AustinZhai8/Smart-Alarm/SmartAlarm/SmartAlarm.ino

#include <TFT_eSPI.h>
#include <WiFi.h>
#include <time.h>
#include <Wire.h>
#include <MPU6050.h>
#include <SPI.h>
#include <SD.h>
#include <HTTPClient.h>
#include <ArduinoJson.h>
#include <EEPROM.h>
#include <ezButton.h>
#include "secrets.h"
#include "sleep_classifier.h"
#include "smart_alarm_features.h"

// pins
#define BL_PIN     32
#define BTN_PIN    33    // sleep / back
#define SD_CS       5
#define BUZZER_PIN 25
#define CLK_PIN    16    // encoder CLK (interrupt)
#define DT_PIN      4    // encoder DT
#define SW_PIN     34    // encoder button

// home screen colors
#define C_OFFWHITE  0xDEDB
#define C_DIM       0x7BEF
#define C_DIMMER    0x4208
uint16_t C_CYAN;

// menu colors
#define COL_BG        0x0000
#define COL_TEXT      0xF77C  // off-white
#define COL_ACCENT    0x8E9F  // cyan
#define COL_DEEP      0x9C5E  // purple
#define COL_KNOBTEXT  0x08A3  // text on accent fills
#define COL_TEXT_75   0xB596
#define COL_TEXT_55   0x8410
#define COL_TEXT_40   0x630C
#define COL_TEXT_30   0x4A49
#define COL_HAIRLINE  0x18E3  // divider
#define COL_DIMSLOT   0x10A2  // slot background

const char* OWM_CITY = "Calgary,CA";

TFT_eSPI tft = TFT_eSPI();
MPU6050  mpu;
ezButton encBtn(SW_PIN);
ezButton backBtn(BTN_PIN);

// navigation
enum Screen {
  HOME, MENU, ALARM_MENU, EDIT_ALARM, EDIT_WAKE,
  SLEEP_DATA, WEATHER, SETTINGS, RESTART, BOOT
};
Screen screen = HOME;
bool   dirty  = true;   // redraw requested

struct AlarmCfg { bool on; uint8_t hour, minute; };       // 24h
struct WakeCfg  { bool on; uint8_t windowMin, sens; };     // 5..60 / 1..3
AlarmCfg alarmCfg = { true, 6, 30 };
WakeCfg  wake  = { true, 30, 2 };
uint8_t  snoozeDurationMin = 10;   // snooze length 1..30

const char* MENU_ITEMS[6] = {
  "Enter Sleep Mode", "Alarm", "Sleep Data", "Weather", "Settings", "Restart"
};
const char* ALARM_ITEMS[2] = { "Edit Alarm", "Smart Alarm" };

uint8_t menuSel    = 1;   // start on "Alarm"
uint8_t alarmSel   = 0;
uint8_t alarmField = 0;   // 0=enabled 1=h 2=m
uint8_t wakeField  = 1;   // 0=enabled 1=minutes 2=sens
bool    rChoiceYes = false;

// alarm ring state
bool          ringing       = false;
unsigned long lastBeepMs    = 0;
bool          alarmFlashOn  = false;
int           lastCheckMin  = -1;
bool          alarmFromSleep = false;   // alarm fired from sleep
unsigned long ringStartMs   = 0;
#define RING_TIMEOUT_MS (3UL * 60UL * 1000UL)   // auto-off after 3 min

// encoder ISR
volatile int  counter   = 0;
volatile unsigned long lastTime = 0;

void IRAM_ATTR ISR_encoder() {
  if ((millis() - lastTime) < 50) return;
  lastTime = millis();
  if (digitalRead(DT_PIN) == HIGH) counter++;
  else                             counter--;
}

// state
bool     sleeping     = false;
String   weatherStr   = "CLEAR · --°";
bool     weatherDirty = true;
char     prevTimeBuf[6]  = "";
char     prevDateBuf[12] = "";
File     dataFile;
int      writeCount   = 0;

// sleep-stage classifier
SmartAlarm::SleepClassifier sleepClf;
File     stageFile;                 // /sleep_stages.csv (timestamp,raw,smoothed)
bool     sleepSummaryDirty = true;  // reparse stage file on next view
bool     smartWakeUsed     = false; // smart wake fires once per session
bool     sleepSessionStarted = false; // no night tracked yet this power-on
unsigned long wakeGuardMs  = 0;     // blocks re-entering sleep after waking
#define  WAKE_GUARD_MS 3000
// last session summary
#define  SEG_MAX 64
uint8_t  segState[SEG_MAX];          // 0 deep, 1 light
uint16_t segCount[SEG_MAX];
int      segN        = 0;
long     sumDeepWin  = 0;            // deep windows
long     sumLightWin = 0;            // light windows
char     sumStart[6] = "";          // first HH:MM
char     sumEnd[6]   = "";          // last HH:MM

// current weather
int   wxTemp = 0, wxHi = 0, wxLo = 0, wxFeels = 0, wxHumidity = 0, wxWind = 0;
char  wxCond[16] = "Clear";

// 5-day forecast
struct DayWx { char wd[4]; uint8_t icon; int hi, lo; };  // icon: 0 sun 1 partly 2 cloud 3 rain
DayWx forecast[5];
bool  forecastReady = false;

unsigned long lastSensorMs  = 0;
unsigned long lastWeatherMs = 0;
const unsigned long WEATHER_MS = 15UL * 60UL * 1000UL;

// EEPROM
#define EE_MAGIC_ADDR  0
#define EE_MAGIC_VAL   0xAB
#define EE_ALARM_ADDR  1   // on, hour, minute
#define EE_WAKE_ADDR   4   // on, windowMin, sens
#define EE_SNOOZE_ADDR 7   // snooze

void saveConfig() {
  EEPROM.write(EE_MAGIC_ADDR, EE_MAGIC_VAL);
  EEPROM.write(EE_ALARM_ADDR + 0, alarmCfg.on);
  EEPROM.write(EE_ALARM_ADDR + 1, alarmCfg.hour);
  EEPROM.write(EE_ALARM_ADDR + 2, alarmCfg.minute);
  EEPROM.write(EE_WAKE_ADDR + 0, wake.on);
  EEPROM.write(EE_WAKE_ADDR + 1, wake.windowMin);
  EEPROM.write(EE_WAKE_ADDR + 2, wake.sens);
  EEPROM.write(EE_SNOOZE_ADDR, snoozeDurationMin);
  EEPROM.commit();
}

void loadConfig() {
  EEPROM.begin(32);
  if (EEPROM.read(EE_MAGIC_ADDR) != EE_MAGIC_VAL) {
    saveConfig();   // first boot: write defaults
    return;
  }
  alarmCfg.on     = EEPROM.read(EE_ALARM_ADDR + 0);
  alarmCfg.hour   = EEPROM.read(EE_ALARM_ADDR + 1);
  alarmCfg.minute = EEPROM.read(EE_ALARM_ADDR + 2);
  wake.on        = EEPROM.read(EE_WAKE_ADDR + 0);
  wake.windowMin = constrain((int)EEPROM.read(EE_WAKE_ADDR + 1), 5, 60);
  wake.sens      = constrain((int)EEPROM.read(EE_WAKE_ADDR + 2), 1, 3);
  snoozeDurationMin = constrain((int)EEPROM.read(EE_SNOOZE_ADDR), 1, 30);
}

// weather
void fetchWeather() {
  if (WiFi.status() != WL_CONNECTED) return;
  HTTPClient http;
  http.setTimeout(5000);
  String url = "http://api.openweathermap.org/data/2.5/weather?q="
               + String(OWM_CITY) + "&appid=" + String(OWM_API_KEY) + "&units=metric";
  http.begin(url);
  int code = http.GET();
  if (code == 200) {
    String payload = http.getString();
    DynamicJsonDocument doc(1024);
    if (!deserializeJson(doc, payload)) {
      int    temp = (int)round(doc["main"]["temp"].as<float>());
      String desc = doc["weather"][0]["main"].as<String>();
      wxTemp     = temp;
      wxHi       = (int)round(doc["main"]["temp_max"].as<float>());
      wxLo       = (int)round(doc["main"]["temp_min"].as<float>());
      wxFeels    = (int)round(doc["main"]["feels_like"].as<float>());
      wxHumidity = doc["main"]["humidity"].as<int>();
      wxWind     = (int)round(doc["wind"]["speed"].as<float>() * 3.6);  // m/s -> km/h
      strncpy(wxCond, desc.c_str(), sizeof(wxCond) - 1);
      wxCond[sizeof(wxCond) - 1] = '\0';
      desc.toUpperCase();
      weatherStr   = desc + " · " + String(temp) + "°";
      weatherDirty = true;
    }
  }
  http.end();
}

// weather condition -> icon index
uint8_t condToIcon(const char* main) {
  if (strstr(main, "Rain") || strstr(main, "Drizzle") || strstr(main, "Thunder")) return 3;
  if (strstr(main, "Cloud")) {
    if (strstr(main, "few") || strstr(main, "scattered")) return 1;
    return 2;
  }
  if (strstr(main, "Clear")) return 0;
  return 1;  // mist/haze/snow -> partly
}

// fetch 5-day forecast (3-hourly, aggregated to daily hi/lo + noon condition)
void fetchForecast() {
  if (WiFi.status() != WL_CONNECTED) return;
  HTTPClient http;
  http.setTimeout(6000);
  String url = "http://api.openweathermap.org/data/2.5/forecast?q="
               + String(OWM_CITY) + "&appid=" + String(OWM_API_KEY) + "&units=metric";
  http.begin(url);
  int code = http.GET();
  if (code != 200) { http.end(); return; }

  // only parse the fields we need
  StaticJsonDocument<200> filter;
  filter["list"][0]["dt"] = true;
  filter["list"][0]["main"]["temp_max"] = true;
  filter["list"][0]["main"]["temp_min"] = true;
  filter["list"][0]["weather"][0]["main"] = true;

  DynamicJsonDocument doc(8192);
  DeserializationError err = deserializeJson(doc, http.getStream(),
                                             DeserializationOption::Filter(filter));
  http.end();
  if (err) return;

  JsonArray list = doc["list"].as<JsonArray>();

  // group by day, up to 5 days
  long    dayKey[5];
  int     dHi[5], dLo[5];
  long    dNoonDelta[5];   // distance from noon of the chosen icon entry
  uint8_t dIcon[5];
  int     nDays = 0;

  for (JsonObject item : list) {
    long dt = item["dt"].as<long>();
    time_t t = (time_t)dt;
    struct tm lt;
    localtime_r(&t, &lt);

    long key = (long)(lt.tm_year) * 1000 + lt.tm_yday;
    long secOfDay = (long)lt.tm_hour * 3600 + lt.tm_min * 60 + lt.tm_sec;
    long noonDelta = labs(secOfDay - 43200L);

    int hi = (int)round(item["main"]["temp_max"].as<float>());
    int lo = (int)round(item["main"]["temp_min"].as<float>());
    const char* mn = item["weather"][0]["main"] | "Clear";

    int idx = -1;
    for (int i = 0; i < nDays; i++) if (dayKey[i] == key) { idx = i; break; }
    if (idx < 0) {
      if (nDays >= 5) continue;
      idx = nDays++;
      dayKey[idx] = key;
      dHi[idx] = hi; dLo[idx] = lo;
      dNoonDelta[idx] = noonDelta; dIcon[idx] = condToIcon(mn);
      strftime(forecast[idx].wd, sizeof(forecast[idx].wd), "%a", &lt);
      for (int c = 0; forecast[idx].wd[c]; c++) forecast[idx].wd[c] = toupper(forecast[idx].wd[c]);
    } else {
      if (hi > dHi[idx]) dHi[idx] = hi;
      if (lo < dLo[idx]) dLo[idx] = lo;
      if (noonDelta < dNoonDelta[idx]) { dNoonDelta[idx] = noonDelta; dIcon[idx] = condToIcon(mn); }
    }
  }

  for (int i = 0; i < nDays; i++) {
    forecast[i].hi = dHi[i];
    forecast[i].lo = dLo[i];
    forecast[i].icon = dIcon[i];
  }
  for (int i = nDays; i < 5; i++) { strcpy(forecast[i].wd, "--"); forecast[i].hi = forecast[i].lo = 0; forecast[i].icon = 1; }
  forecastReady = (nDays > 0);
}

// home screen (incremental redraw to avoid flicker)
void drawStaticElements() {
  tft.drawFastHLine(14, 282, 212, 0x2104);
}

void redrawBottomBar() {
  tft.fillRect(0, 287, 240, 33, TFT_BLACK);
  tft.setTextColor(C_DIMMER, TFT_BLACK);
  tft.drawString(weatherStr, 14, 302, 2);
  char almStr[20];
  if (alarmCfg.on) {
    int h = alarmCfg.hour % 12; if (h == 0) h = 12;
    sprintf(almStr, "ALARM: %d:%02d %s", h, alarmCfg.minute, alarmCfg.hour >= 12 ? "PM" : "AM");
  } else {
    strcpy(almStr, "ALARM: OFF");
  }
  tft.drawString(almStr, 226 - tft.textWidth(almStr, 2), 302, 2);
  weatherDirty = false;
}

void updateDisplay() {
  struct tm ti;
  if (!getLocalTime(&ti)) return;

  char dateBuf[12];
  strftime(dateBuf, sizeof(dateBuf), "%d %b", &ti);
  for (int i = 0; dateBuf[i]; i++) dateBuf[i] = toupper(dateBuf[i]);

  if (strcmp(dateBuf, prevDateBuf) != 0) {
    strcpy(prevDateBuf, dateBuf);
    char dayBuf[12];
    strftime(dayBuf, sizeof(dayBuf), "%A", &ti);
    for (int i = 0; dayBuf[i]; i++) dayBuf[i] = toupper(dayBuf[i]);
    tft.fillRect(0, 18, 200, 32, TFT_BLACK);
    tft.setTextColor(C_DIM, TFT_BLACK);
    tft.drawString(dayBuf, 16, 20, 2);
    tft.setTextColor(C_CYAN, TFT_BLACK);
    tft.drawString(dateBuf, 16, 34, 2);
  }

  int h = ti.tm_hour % 12;
  if (h == 0) h = 12;
  bool isPM = ti.tm_hour >= 12;
  char timeBuf[6];
  sprintf(timeBuf, "%d:%02d", h, ti.tm_min);

  if (strcmp(timeBuf, prevTimeBuf) != 0) {
    strcpy(prevTimeBuf, timeBuf);
    tft.fillRect(0, 95, 240, 80, TFT_BLACK);
    tft.setTextColor(C_OFFWHITE, TFT_BLACK);
    tft.drawString(timeBuf, (240 - tft.textWidth(timeBuf, 7)) / 2, 100, 7);
    tft.fillRect(0, 156, 240, 16, TFT_BLACK);
    tft.setTextColor(C_DIMMER, TFT_BLACK);
    const char* ampm = isPM ? "PM" : "AM";
    tft.drawString(ampm, (240 - tft.textWidth(ampm, 2)) / 2, 158, 2);
  }

  if (weatherDirty) redrawBottomBar();
}

// redraw home from scratch (returning from a menu)
void enterHome() {
  screen = HOME;
  tft.fillScreen(TFT_BLACK);
  drawStaticElements();
  prevTimeBuf[0] = '\0';
  prevDateBuf[0] = '\0';
  weatherDirty   = true;
  updateDisplay();
}

// degree symbol (fonts lack it)
void drawDegree(int x, int y, uint16_t color) {
  tft.drawCircle(x, y, 2, color);
}

void drawSubHeader(const char* title) {
  tft.fillRect(0, 0, 240, 44, TFT_BLACK);
  char up[24];
  strncpy(up, title, sizeof(up) - 1); up[sizeof(up) - 1] = '\0';
  for (int i = 0; up[i]; i++) up[i] = toupper(up[i]);
  tft.setTextColor(COL_TEXT_30, TFT_BLACK);
  tft.drawString(up, 16, 18, 2);
  tft.drawString("< BACK", 226 - tft.textWidth("< BACK", 2), 20, 2);
  tft.drawFastHLine(16, 44, 208, COL_HAIRLINE);
}

void drawAccentBar(int y, int h) {
  int inset = h / 5;
  tft.fillRect(0, y + inset, 2, h - 2 * inset, COL_ACCENT);
}

void drawToggle(int x, int y, bool on, bool focused) {
  // 38x20 capsule
  uint16_t track = on ? COL_ACCENT : COL_DIMSLOT;
  tft.fillRoundRect(x, y, 38, 20, 10, track);
  uint16_t knob = on ? COL_KNOBTEXT : COL_TEXT_55;
  int kx = on ? x + 28 : x + 10;
  tft.fillCircle(kx, y + 10, 8, knob);
  if (focused) tft.drawRoundRect(x - 2, y - 2, 42, 24, 12, COL_ACCENT);
}

// screens
void clearContent() { tft.fillRect(0, 45, 240, 275, TFT_BLACK); }

void drawMenu() {
  drawSubHeader("Menu");
  clearContent();
  int rowH = 36, y0 = 52;
  for (int i = 0; i < 6; i++) {
    int y = y0 + i * rowH;
    bool sel = (i == menuSel);
    if (sel) drawAccentBar(y, rowH);
    tft.setTextColor(sel ? COL_ACCENT : COL_TEXT_55, TFT_BLACK);
    tft.drawString(MENU_ITEMS[i], 22, y + (rowH - 16) / 2, 2);
  }
  // scrollbar
  tft.fillRect(234, 50, 2, 264, COL_DIMSLOT);
  tft.fillRect(234, 50, 2, 264, COL_TEXT_30);
}

void drawAlarmMenu() {
  drawSubHeader("Alarm");
  clearContent();
  int rowH = 44, y0 = 58;
  bool status[2] = { alarmCfg.on, wake.on };
  for (int i = 0; i < 2; i++) {
    int y = y0 + i * rowH;
    bool sel = (i == alarmSel);
    if (sel) drawAccentBar(y, rowH);
    tft.setTextColor(sel ? COL_ACCENT : COL_TEXT_55, TFT_BLACK);
    tft.drawString(ALARM_ITEMS[i], 22, y + (rowH - 16) / 2, 2);
    const char* st = status[i] ? "ON" : "OFF";
    tft.setTextColor(status[i] ? COL_ACCENT : COL_TEXT_30, TFT_BLACK);
    tft.drawString(st, 220 - tft.textWidth(st, 2), y + (rowH - 16) / 2, 2);
  }
}

void drawEditAlarm() {
  drawSubHeader("Edit Alarm");
  clearContent();
  // alarm row + toggle
  if (alarmField == 0) drawAccentBar(52, 28);
  tft.setTextColor(alarmField == 0 ? COL_ACCENT : COL_TEXT_75, TFT_BLACK);
  tft.drawString("Alarm", 22, 58, 2);
  drawToggle(180, 56, alarmCfg.on, alarmField == 0);
  tft.drawFastHLine(18, 92, 204, COL_HAIRLINE);

  // big HH:MM
  char hh[3], mm[3];
  sprintf(hh, "%02d", alarmCfg.hour);
  sprintf(mm, "%02d", alarmCfg.minute);
  uint16_t base = alarmCfg.on ? COL_TEXT : COL_TEXT_40;
  int wH = tft.textWidth(hh, 7), wC = tft.textWidth(":", 7), wM = tft.textWidth(mm, 7);
  int total = wH + wC + wM;
  int x = (240 - total) / 2, y = 120;
  tft.setTextColor(alarmField == 1 ? COL_ACCENT : base, TFT_BLACK);
  tft.drawString(hh, x, y, 7);
  if (alarmField == 1 && alarmCfg.on) tft.fillRect(x, y + 56, wH, 2, COL_ACCENT);
  tft.setTextColor(base, TFT_BLACK);
  tft.drawString(":", x + wH, y, 7);
  tft.setTextColor(alarmField == 2 ? COL_ACCENT : base, TFT_BLACK);
  tft.drawString(mm, x + wH + wC, y, 7);
  if (alarmField == 2 && alarmCfg.on) tft.fillRect(x + wH + wC, y + 56, wM, 2, COL_ACCENT);

  tft.setTextColor(COL_TEXT_30, TFT_BLACK);
  tft.drawCentreString("TURN: ADJUST  PRESS: NEXT", 120, 300, 2);
}

void drawEditWake() {
  drawSubHeader("Smart Alarm");
  clearContent();
  if (wakeField == 0) drawAccentBar(52, 28);
  tft.setTextColor(wakeField == 0 ? COL_ACCENT : COL_TEXT_75, TFT_BLACK);
  tft.drawString("Smart Wake", 22, 58, 2);
  drawToggle(180, 56, wake.on, wakeField == 0);
  tft.drawFastHLine(18, 92, 204, COL_HAIRLINE);

  // minutes + MIN
  char mb[4]; sprintf(mb, "%d", wake.windowMin);
  uint16_t base = wake.on ? COL_TEXT : COL_TEXT_40;
  int wN = tft.textWidth(mb, 7);
  int x = (240 - wN - 30) / 2, y = 110;
  tft.setTextColor(wakeField == 1 ? COL_ACCENT : base, TFT_BLACK);
  tft.drawString(mb, x, y, 7);
  if (wakeField == 1 && wake.on) tft.fillRect(x, y + 56, wN, 2, COL_ACCENT);
  tft.setTextColor(COL_TEXT_40, TFT_BLACK);
  tft.drawString("MIN", x + wN + 6, y + 36, 2);
  tft.setTextColor(wake.on ? COL_TEXT_40 : COL_TEXT_30, TFT_BLACK);
  tft.drawCentreString("Wake window before alarm", 120, 178, 2);

  // sensitivity chips
  tft.setTextColor(wakeField == 2 ? COL_ACCENT : COL_TEXT_75, TFT_BLACK);
  tft.drawString("Sensitivity", 22, 214, 2);
  int cx = 150;
  for (int n = 1; n <= 3; n++) {
    int bx = cx + (n - 1) * 24;
    bool active = (n == wake.sens);
    tft.fillRoundRect(bx, 210, 18, 18, 5, active ? COL_ACCENT : COL_DIMSLOT);
    if (active && wakeField == 2) tft.drawRoundRect(bx - 1, 209, 20, 20, 6, COL_ACCENT);
    char d[2] = { (char)('0' + n), '\0' };
    tft.setTextColor(active ? COL_KNOBTEXT : COL_TEXT_40);
    tft.drawCentreString(d, bx + 9, 212, 2);
  }
  tft.setTextColor(COL_TEXT_30, TFT_BLACK);
  tft.drawString("Higher = wakes sooner", 22, 236, 2);

  tft.setTextColor(COL_TEXT_30, TFT_BLACK);
  tft.drawCentreString("TURN: ADJUST  PRESS: NEXT", 120, 300, 2);
}

// windows -> "Xh Ym"
void fmtHM(long windows, char* buf, size_t n) {
  long sec = windows * 30L;
  int h = sec / 3600;
  int m = (sec % 3600) / 60;
  snprintf(buf, n, "%dh %02dm", h, m);
}

// parse /sleep_stages.csv into the summary globals (run-length encoded)
void parseSleepSummary() {
  segN = 0; sumDeepWin = 0; sumLightWin = 0;
  sumStart[0] = '\0'; sumEnd[0] = '\0';

  File f = SD.open("/sleep_stages.csv", FILE_READ);
  if (!f) return;

  bool first = true;
  int  curState = -1;
  while (f.available()) {
    String line = f.readStringUntil('\n');
    if (first) { first = false; continue; }      // skip header
    line.trim();
    if (line.length() < 3) continue;

    int lastComma = line.lastIndexOf(',');
    if (lastComma < 0) continue;
    String sm = line.substring(lastComma + 1);
    int state = (sm == "light") ? 1 : 0;          // 1 light, 0 deep

    if (state) sumLightWin++; else sumDeepWin++;

    // grab HH:MM from "YYYY-MM-DD HH:MM:SS"
    if (line.length() >= 16 && line[13] == ':') {
      char hm[6];
      line.substring(11, 16).toCharArray(hm, sizeof(hm));
      if (sumStart[0] == '\0') strcpy(sumStart, hm);
      strcpy(sumEnd, hm);
    }

    // run-length encode
    if (state != curState) {
      curState = state;
      if (segN < SEG_MAX) { segState[segN] = state; segCount[segN] = 1; segN++; }
      else                 segCount[SEG_MAX - 1]++;   // overflow: lump in
    } else if (segN > 0) {
      segCount[segN - 1]++;
    }
  }
  f.close();
}

// Empty state for the Sleep Data screen: a representative night shape,
// shown before this unit has tracked one so the layout is never blank on
// a fresh boot. enterSleepMode() wipes /sleep_stages.csv, so the first
// real session takes over from here.
void fillPreviewSummary() {
  static const uint8_t  previewState[] = { 1, 0, 1, 0, 1, 0, 1, 0, 1, 0, 1, 0, 1, 0, 1, 0, 1 };
  static const uint16_t previewCount[] = { 36,64,28,52,40,44,54,34,66,26,58,20,78,16,96,12,110 };
  segN = sizeof(previewState) / sizeof(previewState[0]);
  sumDeepWin = 0; sumLightWin = 0;
  for (int i = 0; i < segN; i++) {
    segState[i] = previewState[i];
    segCount[i] = previewCount[i];
    if (previewState[i]) sumLightWin += previewCount[i]; else sumDeepWin += previewCount[i];
  }
  strcpy(sumStart, "23:15");
  strcpy(sumEnd,   "06:12");
}

void drawSleepData() {
  if (sleepSummaryDirty) { parseSleepSummary(); sleepSummaryDirty = false; }

  drawSubHeader("Sleep Data");
  clearContent();

  long totalWin = sumDeepWin + sumLightWin;
  if (!sleepSessionStarted) {                // nothing tracked yet: show the empty state
    fillPreviewSummary();
    totalWin = sumDeepWin + sumLightWin;
  }

  char hm[12];
  fmtHM(totalWin, hm, sizeof(hm));
  tft.setTextColor(COL_TEXT, TFT_BLACK);
  tft.drawString(hm, 18, 58, 4);
  tft.setTextColor(COL_TEXT_40, TFT_BLACK);
  tft.drawString("LAST NIGHT", 120, 64, 2);

  // two-lane hypnogram
  int x0 = 18, w = 204, gap = (segN > 1) ? 2 : 0;
  float avail = w - gap * (segN - 1);
  if (avail < 1) avail = w;
  int yL = 110, yD = 142, hh = 26;
  float fx = x0;
  for (int i = 0; i < segN; i++) {
    int bw = (int)(avail * ((float)segCount[i] / (float)totalWin));
    if (bw < 2) bw = 2;
    bool light = (segState[i] == 1);
    tft.fillRoundRect((int)fx, yL, bw, hh, 3, light ? COL_ACCENT : COL_DIMSLOT);
    tft.fillRoundRect((int)fx, yD, bw, hh, 3, light ? COL_DIMSLOT : COL_DEEP);
    fx += bw + gap;
  }

  // start / end times
  tft.setTextColor(COL_TEXT_40, TFT_BLACK);
  if (sumStart[0]) tft.drawString(sumStart, x0, yD + hh + 6, 2);
  if (sumEnd[0])   tft.drawString(sumEnd, x0 + w - tft.textWidth(sumEnd, 2), yD + hh + 6, 2);

  // legend
  fmtHM(sumLightWin, hm, sizeof(hm));
  char lg[20];
  tft.fillRoundRect(40, 210, 8, 8, 2, COL_ACCENT);
  tft.setTextColor(COL_TEXT_75, TFT_BLACK);
  snprintf(lg, sizeof(lg), "Light %s", hm);
  tft.drawString(lg, 54, 208, 2);

  fmtHM(sumDeepWin, hm, sizeof(hm));
  tft.fillRoundRect(40, 232, 8, 8, 2, COL_DEEP);
  snprintf(lg, sizeof(lg), "Deep %s", hm);
  tft.drawString(lg, 54, 230, 2);
}

// weather icon
void drawWxIcon(int cx, int cy, uint8_t type, uint16_t color) {
  switch (type) {
    case 0: // sun
      tft.drawCircle(cx, cy, 5, color);
      for (int a = 0; a < 360; a += 45) {
        float r = a * 0.01745;
        tft.drawLine(cx + cos(r) * 7, cy + sin(r) * 7, cx + cos(r) * 9, cy + sin(r) * 9, color);
      }
      break;
    case 1: // partly
      tft.drawCircle(cx - 3, cy - 2, 4, color);
      tft.fillRoundRect(cx - 4, cy + 1, 14, 7, 3, color);
      break;
    case 2: // cloud
      tft.fillRoundRect(cx - 7, cy - 1, 16, 8, 4, color);
      tft.fillCircle(cx - 2, cy - 3, 4, color);
      break;
    case 3: // rain
      tft.fillRoundRect(cx - 7, cy - 3, 16, 7, 3, color);
      tft.drawLine(cx - 4, cy + 6, cx - 5, cy + 9, color);
      tft.drawLine(cx,     cy + 6, cx - 1, cy + 9, color);
      tft.drawLine(cx + 4, cy + 6, cx + 3, cy + 9, color);
      break;
  }
}

void drawWeather() {
  drawSubHeader("Weather");
  clearContent();
  // big temp
  char tb[6]; sprintf(tb, "%d", wxTemp);
  tft.setTextColor(COL_TEXT, TFT_BLACK);
  tft.drawString(tb, 18, 58, 7);
  drawDegree(18 + tft.textWidth(tb, 7) + 6, 64, COL_TEXT);
  tft.setTextColor(COL_ACCENT, TFT_BLACK);
  tft.drawString(wxCond, 20, 120, 2);
  drawWxIcon(200, 80, condToIcon(wxCond), COL_TEXT_75);

  // detail row
  char det[40];
  tft.setTextColor(COL_TEXT_55, TFT_BLACK);
  sprintf(det, "H %d  L %d", wxHi, wxLo);
  tft.drawString(det, 18, 150, 2);
  sprintf(det, "Feels %d", wxFeels);
  tft.drawString(det, 100, 150, 2);
  sprintf(det, "%d%%  %dkm/h", wxHumidity, wxWind);
  tft.drawString(det, 160, 150, 2);

  tft.drawFastHLine(16, 174, 208, COL_HAIRLINE);

  // 5-day columns
  int colW = 240 / 5;
  for (int i = 0; i < 5; i++) {
    int cx = colW * i + colW / 2;
    tft.setTextColor(COL_TEXT_30, TFT_BLACK);
    tft.drawCentreString(forecast[i].wd, cx, 188, 2);
    drawWxIcon(cx, 218, forecast[i].icon, COL_TEXT_55);
    char hl[5];
    tft.setTextColor(COL_TEXT, TFT_BLACK);
    sprintf(hl, "%d", forecast[i].hi);
    tft.drawCentreString(hl, cx, 238, 2);
    tft.setTextColor(COL_TEXT_40, TFT_BLACK);
    sprintf(hl, "%d", forecast[i].lo);
    tft.drawCentreString(hl, cx, 258, 2);
  }
}

void drawSettings() {
  drawSubHeader("Settings");
  clearContent();
  drawAccentBar(58, 28);
  tft.setTextColor(COL_ACCENT, TFT_BLACK);
  tft.drawString("Snooze Duration", 22, 64, 2);

  char mb[4]; sprintf(mb, "%d", snoozeDurationMin);
  int wN = tft.textWidth(mb, 7);
  int x = (240 - wN - 30) / 2, y = 130;
  tft.setTextColor(COL_ACCENT, TFT_BLACK);
  tft.drawString(mb, x, y, 7);
  tft.fillRect(x, y + 56, wN, 2, COL_ACCENT);
  tft.setTextColor(COL_TEXT_40, TFT_BLACK);
  tft.drawString("MIN", x + wN + 6, y + 36, 2);
  tft.drawCentreString("Snooze length", 120, y + 70, 2);

  tft.setTextColor(COL_TEXT_30, TFT_BLACK);
  tft.drawCentreString("TURN: ADJUST  PRESS: BACK", 120, 300, 2);
}

void drawRestart() {
  drawSubHeader("Restart");
  clearContent();
  tft.setTextColor(COL_TEXT, TFT_BLACK);
  tft.drawCentreString("Restart device?", 120, 110, 4);
  tft.setTextColor(COL_TEXT_40, TFT_BLACK);
  tft.drawCentreString("The clock will be unavailable", 120, 150, 2);
  tft.drawCentreString("for a few seconds.", 120, 168, 2);

  // No | Yes buttons
  int by = 210, bh = 40, bw = 90;
  int nx = 24, yx = 240 - 24 - bw;
  // No
  if (!rChoiceYes) { tft.fillRoundRect(nx, by, bw, bh, 6, COL_ACCENT); tft.setTextColor(COL_KNOBTEXT, COL_ACCENT); }
  else             { tft.drawRoundRect(nx, by, bw, bh, 6, COL_TEXT_30); tft.setTextColor(COL_TEXT_55, COL_BG); }
  tft.drawCentreString("No", nx + bw / 2, by + 12, 2);
  // Yes
  if (rChoiceYes)  { tft.fillRoundRect(yx, by, bw, bh, 6, COL_ACCENT); tft.setTextColor(COL_KNOBTEXT, COL_ACCENT); }
  else             { tft.drawRoundRect(yx, by, bw, bh, 6, COL_TEXT_30); tft.setTextColor(COL_TEXT_55, COL_BG); }
  tft.drawCentreString("Yes", yx + bw / 2, by + 12, 2);
}

void drawBoot() {
  tft.fillScreen(TFT_BLACK);
  tft.setTextColor(COL_TEXT_55, TFT_BLACK);
  tft.drawCentreString("Smart Alarm", 120, 150, 4);
  tft.drawFastHLine(70, 180, 100, COL_HAIRLINE);
}

void render() {
  switch (screen) {
    case HOME:       updateDisplay();   break;  // incremental, no full clear
    case MENU:       drawMenu();        break;
    case ALARM_MENU: drawAlarmMenu();   break;
    case EDIT_ALARM: drawEditAlarm();   break;
    case EDIT_WAKE:  drawEditWake();    break;
    case SLEEP_DATA: drawSleepData();   break;
    case WEATHER:    drawWeather();     break;
    case SETTINGS:   drawSettings();    break;
    case RESTART:    drawRestart();     break;
    case BOOT:       drawBoot();        break;
  }
}

// navigation
void onRotate(int dir) {
  switch (screen) {
    case MENU: {
      int s = menuSel + dir;
      if (s < 0) s = 5;
      if (s > 5) s = 0;
      menuSel = s;
      dirty = true; break;
    }
    case ALARM_MENU: {
      int s = alarmSel + dir;
      if (s < 0) s = 1;
      if (s > 1) s = 0;
      alarmSel = s;
      dirty = true; break;
    }
    case EDIT_ALARM:
      if (alarmField == 0) {
        alarmCfg.on = !alarmCfg.on;
      } else if (alarmField == 1) {
        int h = alarmCfg.hour + dir;
        if (h < 0)  h = 23;
        if (h > 23) h = 0;
        alarmCfg.hour = h;
      } else {
        int m = alarmCfg.minute + dir;
        if (m < 0)  m = 59;
        if (m > 59) m = 0;
        alarmCfg.minute = m;
      }
      saveConfig(); dirty = true; break;
    case EDIT_WAKE:
      if (wakeField == 0) {
        wake.on = !wake.on;
      } else if (wakeField == 1) {
        wake.windowMin = constrain(wake.windowMin + dir * 5, 5, 60);
      } else {
        int s = wake.sens + dir;
        if (s < 1) s = 3;
        if (s > 3) s = 1;
        wake.sens = s;
      }
      saveConfig(); dirty = true; break;
    case SETTINGS:
      snoozeDurationMin = constrain(snoozeDurationMin + dir, 1, 30);
      saveConfig(); dirty = true; break;
    case RESTART:
      rChoiceYes = !rChoiceYes; dirty = true; break;
    default: break;
  }
}

void onPress() {
  switch (screen) {
    case HOME:
      screen = MENU; dirty = true; break;
    case MENU:
      switch (menuSel) {
        case 0: enterSleepMode(); break;          // stays in sleep mode
        case 1: screen = ALARM_MENU; dirty = true; break;
        case 2: screen = SLEEP_DATA; sleepSummaryDirty = true; dirty = true; break;
        case 3: screen = WEATHER;    dirty = true; break;
        case 4: screen = SETTINGS;   dirty = true; break;
        case 5: screen = RESTART; rChoiceYes = false; dirty = true; break;
      }
      break;
    case ALARM_MENU:
      screen = (alarmSel == 0) ? EDIT_ALARM : EDIT_WAKE;
      if (screen == EDIT_ALARM) alarmField = 0; else wakeField = 0;
      dirty = true; break;
    case EDIT_ALARM:
      alarmField++;
      if (alarmField > 2) alarmField = 0;
      dirty = true; break;
    case EDIT_WAKE:
      wakeField++;
      if (wakeField > 2) wakeField = 0;
      dirty = true; break;
    case SETTINGS:
      screen = MENU; dirty = true; break;        // one field, press returns to menu
    case RESTART:
      if (rChoiceYes) ESP.restart();
      else { screen = MENU; dirty = true; }
      break;
    default: break;
  }
}

void onBack() {
  switch (screen) {
    case MENU:        enterHome(); break;
    case EDIT_ALARM:
    case EDIT_WAKE:   screen = ALARM_MENU; dirty = true; break;
    case ALARM_MENU:
    case SLEEP_DATA:
    case WEATHER:
    case SETTINGS:
    case RESTART:     screen = MENU; dirty = true; break;
    default: break;  // HOME no-op
  }
}

// logging
void logSensorData() {
  int16_t ax, ay, az, gx, gy, gz;
  mpu.getMotion6(&ax, &ay, &az, &gx, &gy, &gz);

  struct tm ti;
  char ts[25];
  if (getLocalTime(&ti)) strftime(ts, sizeof(ts), "%Y-%m-%d %H:%M:%S", &ti);
  else strcpy(ts, "time_error");

  // feed the classifier; true when a 30s window completes
  bool haveStage = sleepClf.addSample(ax, ay, az);
  int  rawP = sleepClf.lastRaw(), smP = sleepClf.lastSmoothed();

  detachInterrupt(digitalPinToInterrupt(CLK_PIN));
  if (dataFile) {
    dataFile.print(ts);  dataFile.print(",");
    dataFile.print(ax);  dataFile.print(",");
    dataFile.print(ay);  dataFile.print(",");
    dataFile.println(az);
    if (++writeCount >= 20) { dataFile.flush(); writeCount = 0; }
  }
  if (haveStage && stageFile) {
    stageFile.print(ts);                       stageFile.print(",");
    stageFile.print(rawP == 0 ? "deep" : "light"); stageFile.print(",");
    stageFile.println(smP  == 0 ? "deep" : "light");
    stageFile.flush();                         // once per 30s
  }
  attachInterrupt(digitalPinToInterrupt(CLK_PIN), ISR_encoder, FALLING);
}

// sleep mode
void enterSleepMode() {
  sleeping = true;
  screen   = HOME;
  if (dataFile) dataFile.close();
  SD.remove("/sleep_data.csv");
  dataFile = SD.open("/sleep_data.csv", FILE_WRITE);
  dataFile.println("timestamp,aX,aY,aZ");
  writeCount = 0;

  // fresh classifier state + fresh stage file. opened here, closed in exitSleepMode().
  if (stageFile) stageFile.close();   // close stale handle
  SD.remove("/sleep_stages.csv");
  stageFile = SD.open("/sleep_stages.csv", FILE_WRITE);
  stageFile.println("timestamp,raw,smoothed");
  sleepClf.reset();
  smartWakeUsed = false;             // arm smart wake
  sleepSessionStarted = true;        // tracked data drives the screen from here on
  sleepSummaryDirty = true;          // reparse on next view

  ledcWrite(BL_PIN, 0);
  tft.fillScreen(TFT_BLACK);
  Serial.println("Sleep logging started");
}

void exitSleepMode() {
  sleeping = false;
  if (dataFile)  dataFile.close();
  if (stageFile) stageFile.close();   // the one place the stage file closes
  ledcWrite(BL_PIN, 255);
  enterHome();
  wakeGuardMs = millis();             // block accidental immediate re-sleep
  // delay weather refresh ~20s so waking doesn't freeze the UI
  lastWeatherMs = millis() - WEATHER_MS + 20000;
  Serial.println("Sleep logging stopped");
}

// backlight off but keep the log file open (tracking continues)
void screenSleep() {
  screen = HOME;
  ledcWrite(BL_PIN, 0);
  tft.fillScreen(TFT_BLACK);
}

// alarm ring. never touches the SD file (opened in enterSleepMode, closed in exitSleepMode).
void startRinging() {
  alarmFromSleep = sleeping;        // remember if we came from sleep
  ledcWrite(BL_PIN, 255);           // backlight on
  enterHome();                      // draw clock
  ringing      = true;
  lastBeepMs   = 0;
  ringStartMs  = millis();
  alarmFlashOn = false;
}

// stop ringing for good
void stopRinging() {
  ringing = false;
  noTone(BUZZER_PIN);
  if (alarmFromSleep) exitSleepMode();   // closes the log file
  else                enterHome();
  alarmFromSleep = false;
}

void snoozeAlarm() {
  ringing = false;
  noTone(BUZZER_PIN);
  int total = alarmCfg.hour * 60 + alarmCfg.minute + snoozeDurationMin;
  if (total >= 1440) total -= 1440;    // wrap past midnight
  alarmCfg.hour = total / 60;
  alarmCfg.minute = total % 60;        // temporary re-arm (not persisted)
  lastCheckMin = -1;                                         // allow re-fire at snoozed time
  if (alarmFromSleep) screenSleep();   // back to sleep, log stays open
  else                enterHome();
}

void serviceRinging() {
  unsigned long now = millis();
  if (now - ringStartMs >= RING_TIMEOUT_MS) {   // auto-off if unanswered
    stopRinging();
    return;
  }
  updateDisplay();   // keep clock updated
  if (now - lastBeepMs >= 500) {
    lastBeepMs = now;
    tone(BUZZER_PIN, 1000, 200);
    alarmFlashOn = !alarmFlashOn;
    // flash banner below AM/PM
    tft.fillRect(0, 205, 240, 42, TFT_BLACK);
    if (alarmFlashOn) {
      tft.setTextColor(COL_ACCENT, TFT_BLACK);
      tft.drawCentreString("ALARM", 120, 210, 4);
    }
  }
}

void checkAlarm() {
  // runs in both sleep and wake
  if (ringing || !alarmCfg.on) return;
  struct tm ti;
  if (!getLocalTime(&ti)) return;

  // smart wake: ring early if inside the wake window and in light sleep long enough
  if (wake.on && sleeping && !smartWakeUsed) {
    int required = 4 - wake.sens;            // sens 3->1, 2->2, 1->3 windows
    if (required < 1) required = 1;          // guard bad EEPROM
    int alarmMin = alarmCfg.hour * 60 + alarmCfg.minute;
    int curMin   = ti.tm_hour   * 60 + ti.tm_min;
    int diff = alarmMin - curMin;   // minutes until alarm
    if (diff < 0) diff += 1440;     // wrap past midnight
    if (diff > 0 && diff <= wake.windowMin && sleepClf.lightRun() >= required) {
      smartWakeUsed = true;
      startRinging();
      return;
    }
  }

  if (ti.tm_sec == 0 && ti.tm_min != lastCheckMin) {
    lastCheckMin = ti.tm_min;
    if (ti.tm_hour == alarmCfg.hour && ti.tm_min == alarmCfg.minute) startRinging();
  }
}

// input
unsigned long lastBackActionMs = 0;
#define BACK_LOCKOUT_MS 400

void handleBackButton() {
  unsigned long now = millis();
  if (now - lastBackActionMs < BACK_LOCKOUT_MS) return;  // debounce lockout
  lastBackActionMs = now;

  if (ringing)         { stopRinging(); return; }     // back during alarm = stop
  if (sleeping)        { exitSleepMode(); return; }   // leave sleep mode
  if (screen == HOME)  {                              // start a sleep session
    if (millis() - wakeGuardMs < WAKE_GUARD_MS) return;  // ignore stray press right after waking
    enterSleepMode(); return;
  }
  onBack();
}

// setup
void setup() {
  Serial.begin(115200);

  loadConfig();

  ledcAttach(BL_PIN, 5000, 8);
  ledcWrite(BL_PIN, 255);
  pinMode(BUZZER_PIN, OUTPUT);
  pinMode(CLK_PIN, INPUT);
  pinMode(DT_PIN,  INPUT);
  attachInterrupt(digitalPinToInterrupt(CLK_PIN), ISR_encoder, FALLING);
  encBtn.setDebounceTime(50);
  backBtn.setDebounceTime(150);

  tft.init();
  tft.setRotation(0);
  tft.fillScreen(TFT_BLACK);
  C_CYAN = tft.color565(143, 208, 255);

  drawBoot();

  tft.setTextColor(C_DIM, TFT_BLACK);
  tft.drawCentreString("connecting...", 120, 200, 2);

  WiFi.begin(WIFI_SSID, WIFI_PASS);
  while (WiFi.status() != WL_CONNECTED) delay(500);

  configTime(-6 * 3600, 0, "pool.ntp.org", "time.google.com");
  tft.drawCentreString("syncing time...  ", 120, 200, 2);
  struct tm ti;
  int attempts = 0;
  while (!getLocalTime(&ti) && attempts++ < 20) delay(1000);

  Wire.begin();
  mpu.initialize();

  if (!SD.begin(SD_CS)) {
    Serial.println("SD card failed");
    tft.drawCentreString("SD card failed!", 120, 220, 2);
    delay(2000);
  } else {
    Serial.println("SD card ready");
  }

  fetchWeather();
  fetchForecast();
  lastWeatherMs = millis();

  enterHome();
  Serial.println("Setup complete");
}

// loop
void loop() {
  encBtn.loop();
  backBtn.loop();

  // encoder rotation
  static int lastCounter = 0;
  noInterrupts();
  int c = counter;
  interrupts();
  if (c != lastCounter) {
    int step = (c > lastCounter) ? 1 : -1;
    int ticks = abs(c - lastCounter);
    lastCounter = c;
    if (ringing) {
      snoozeAlarm();                         // any rotation while ringing = snooze
    } else {
      for (int i = 0; i < ticks; i++) onRotate(step);
    }
  }

  // encoder click
  if (encBtn.isPressed()) {
    if (ringing) stopRinging();              // click while ringing = stop
    else         onPress();
  }

  // back / sleep / snooze button
  if (backBtn.isPressed()) handleBackButton();

  unsigned long now = millis();

  if (ringing) {
    serviceRinging();
    return;
  }

  if (now - lastSensorMs >= 500) {
    lastSensorMs = now;
    if (sleeping)            logSensorData();
    else if (screen == HOME) updateDisplay();
  }

  if (dirty && !sleeping) {
    render();
    dirty = false;
  }

  checkAlarm();

  if (!sleeping && now - lastWeatherMs >= WEATHER_MS) {
    lastWeatherMs = now;
    fetchWeather();
    fetchForecast();
    if (screen == HOME) weatherDirty = true;
  }
}
