AustinZhai8/Smart-Alarm/(commit log)

2026-05-21 Started developing data collection
    [sleep_data.csv]
2026-05-24 Desined UI
    [sleep_data.csv]
2026-05-26 Added lots of features
    [Night 1.csv, No Movement.csv]
2026-05-26 Organize sleep data and fix backlight control
    - Move Night 1.csv and No Movement.csv into sleep data/ folder
    - Add sleep stage labels (awake/light/deep/REM) to Night 1.csv
    - Label all rows in No Movement.csv as deep sleep
    - Switch backlight from digitalWrite to PWM via ledcAttach/ledcWrite
    - Fix degree symbol rendering by using C suffix (font 2 ASCII limit)
    - Add .gitignore with secrets.h excluded
    [Night 1.csv, No Movement.csv]
2026-05-26 Add labeled Night 2 sleep data
    [Night 2.csv]
2026-05-27 Night 3 data
    [Night 1.csv, Night 2.csv, Night 3.csv]
2026-05-29 Night 4
    [Night 4.csv]
2026-05-31 Night 5
    [Night 5.csv]
2026-06-03 Firmware updates
    [Night 6.csv]
2026-06-05 Night 7
    [Night 6.csv, Night 7.csv]
2026-06-20 Data change for ml
    [Night 1.csv, Night 2.csv, Night 3.csv, Night 4.csv, Night 5.csv, Night 6.csv, Night 7.csv, Night 8.csv]
2026-06-23 Data updates and ML model
    [Night 2.csv, Night 3.csv, Night 4.csv, Night 5.csv, Night 6.csv, Night 7.csv]
